sms-ebarbeito/aux-sniffer/(commit log)

2026-11-01 SPEC, decodificador de referencia y vectores de prueba del sniffer AUX
2026-11-01 Decodificador AUX portable (auxdec) y test de host con los vectores reales
    Port de auxdec.py sin dependencias de Arduino: cuantiza corridas a medios
    bits (round-half-even como Python), busca SYNC en ambas polaridades y extrae
    todos los mensajes de la ráfaga (pedido + respuesta). Incluye la conversión
    desde símbolos RMT y la clasificación de 80 06 00 00 XX.
    El test (make -C test) verifica los 3 vectores, polaridad invertida, el
    pipeline RMT a 50/100 ns, jitter de ±100 ns, truncado en cada corrida y en
    cada símbolo RMT, dos transacciones en una ráfaga y ruido aleatorio.
    [auxdec.cpp, auxdec.h]
2026-11-01 Firmware ESP32: captura RMT RX, decodificación y control de backlight
    - config.h: único lugar para placa (C3 SuperMini por defecto según FQBN;
    S3 y WROOM secundarios), pines, LED, memoria RMT y modo de backlight.
    - BL_MODE_DIRECT_OD (default): GPIO open-drain sin pulls al pad de BL_EN,
    LOW=OFF y suelto=ON. BL_MODE_MOSFET: 2N7002 del SPEC, HIGH=OFF.
    El pin se suelta en initVariant(), antes de setup(), y en esp_restart().
    - RMT RX a 10 MHz con 2 bloques en la C3 (96 símbolos, ping-pong del
    driver hacia buffers de 512), anillo de 4 buffers rearmado en la ISR y
    cola hacia una tarea de alta prioridad que actúa sobre el pin.
    - El Serial se imprime desde loop() a través de otra cola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
2026-11-01 README y orden del log de debug
    README: test de host, compilación (build.sh, FQBN, CDCOnBoot, ctags en
    Apple Silicon), flasheo con arduino-cli, cableado de los dos modos de
    backlight (directo open-drain y MOSFET), salida por Serial y cómo entra la
    ráfaga en el RMT de la C3. El mensaje se encola antes de actuar para que
    '>>> BACKLIGHT' salga después del REQ que lo causó.
2026-11-01 Documentar el cableado final del backlight (directo con pull-up externa)
    SPEC §2 y README: la pista de BL_EN está cortada, GPIO5 va directo a BL_EN
    en open-drain sin pulls internos y una pull-up externa de 10 kΩ al 3,3 V
    del adaptador (lado panel) la mantiene en alto. Se explica por qué la
    pull-up es externa: el backlight queda encendido aunque el ESP32 esté en
    reset, en el bootloader o colgado. El 2N7002 queda como alternativa
    (BL_MODE_MOSFET, no montada). SPEC §5 describe la lógica para los dos modos.
    README: estado en hardware (reposo y despertar probados en la C3
    SuperMini) y lo que falta verificar.
2026-11-01 Comentarios del modo directo: pull-up externa de 10 kΩ en vez del 1 kΩ
    Solo comentarios (config.h y aux_sniffer.ino), para que describan el
    cableado final: pista de BL_EN cortada, GPIO directo a BL_EN y pull-up
    externa de 10 kΩ al 3,3 V del adaptador.
    Verificado con build.sh all: el desensamblado es idéntico en c3, s3 y
    wroom. En el .bin solo cambian app_elf_sha256 (por la info de depuración),
    la hora de compilación y el hash de la imagen.
2026-11-01 Licencia MIT
    Agrega LICENSE con el texto MIT estándar (Copyright (c) 2026 Enrique
    Barbeito) y una sección "Licencia" al final del README.
2026-11-01 Translate code comments, Serial messages and scripts to English
    Comments in firmware/, test/, build.sh, test/Makefile and tools/ctags-noop
    are now in English, as are the Serial messages and key help printed by the
    firmware, the strings built by auxdec ("[truncated]", "REPLY (empty)") and
    the host test output. No identifiers changed: they were already English.
    Serial output changes, e.g. the stats line is now
    stats: bursts= noise= no_sync= truncated= messages= dropped= log_lost=
    rearms= | backlight= rmt=
    Verified: make -C test -> 140 checks, 0 failures; ./build.sh all builds
    c3, s3 and wroom with no warnings from our files.
    [aux_sniffer.ino, auxdec.cpp, auxdec.h, config.h]
2026-11-01 Translate README and SPEC to English
    Full English versions of README.md and SPEC.md, with English number
    formatting (3.3 V, 13.10 s). The README's Serial example and counter list
    now match the firmware's English messages (no_sync, truncated, dropped,
    log_lost, rearms). Content is otherwise unchanged.
2026-11-02 Phase 2: cut panel VCC while the display sleeps (closes #1) (#2)
    * Phase 2: cut panel VCC while the display sleeps (P-MOSFET on PIN_PANEL_VCC)
    * Tick the VCC cut only with the burst queue drained; keep 1 s poll when disabled
    ---------
2026-11-02 README/SPEC: build photos, FDC606P details, single pin-numbering convention (#4)
